Hoeby/Sapphire/README.md

# Sapphire 3d printer mods

I made some mods to the Sapphire and in particular for the SP3.
Everything is still in testing, use is on your own risk
