Hoeby/Sapphire/triple-z_mod/readme.md

For changing the sapphire SP3 to triple z, i tried to explain every step <br>
Some parts in the pictures could look different, because i am still fine tuning parts. <br>
It is not a commercial modification, use it on you own risk. If there are any deviations, these cannot be recovered. <br>

This mod isn't going about how to wire everything, just the mechanical part. <br>
<p align="center">
  
</p>

# Index:
- <a href="assets/step1_checksquare/readme.md">Align extrusion profiles that they are square</a>
- <a href="assets/step2_left-right_alignparts/readme.md">Front left and right new parts, check before drilling</a>
- <a href="assets/step3_left-right_drilling/readme.md">Front left and right, drilling the holes in the base</a>
- <a href="assets/step4_rear_drilling/readme.md">Rear profile position, drilling the holes in the base</a>
- <a href="assets/step5_mount_rear/readme.md">Mounting rear profile</a>
- <a href="assets/step6_steppermount/readme.md">Mounting stepper motors</a>
- <a href="assets/step7_mount_carriages/readme.md">Mount rail carriages</a>
- <a href="assets/step8_gantry/readme.md">Making gantry</a>
- <a href="assets/step9_mount_bed/readme.md">Mounting bed</a>
<br>
To give you a start, i added the necessary config i am using for z-tilt. <br>
This config is not a complete config for klipper. Only the values needed for z-tilt. <br>
I am using a btt octopus mainboard, check you mainboard pins in your config. <br>
<a href="assets/klipper_config/z_stepper.md">Very basic config for Z-tilt in klipper</a>

## BOM list:
3x  MGN9H linear rail, 300mm long <br>
3x  nema 17 stepper, tr8 x 300mm (spindle and stepper are 1 part) <br>
3x  POM Anti Backlash Nuts For Leadscrew (must fit your spindles) <br>
3x  thrust bearing F8-16M (8x16x5mm) <br>
3x  axis mounting ring (8x25x8mm) <br>
9x  BHCS m3x6mm screw <br>
24x SHDC m3x8mm screw <br>
20x  SHDC m3x12mm screw <br>
4x  SHDC m3x14mm screw <br>
12x SHDC m3x16mm screw <br>
6x SHDC m3x20mm screw <br>
4x SHDC m3x??mm screw (depending on used bed)<br>
26x  BHCS m5x10mm screw <br>
3x SHDC m5x20mm screw <br>
3x  SHDC m6x20mm screw <br>
1x  m6 washer <br>
28x T-nut, spring loaded type for 20 series - M3 <br>
18x T-nut, spring loaded type for 20 series - M5 <br>
3x nut - M5 <br>
4x thumb nut M5 <br>
8x hammernut for 20 series - M5 <br>
6x Threaded inserts M3x5 <br>
3x IGUS eglm05 (cheaper option: GE5C bearing) <br>

### Profiles BOM list:
1x 2020 profile 303,0mm long <br>
1x 2020 profile 334,5mm long <br>
1x 2020 profile 316,0mm long <br>
2x 2020 profile 225,0mm long <br>
1x 2020 profile 189,0mm long <br>
