Hoeby/Sapphire/IO-mount_klicky/beta/readme.md

Made a new A_bottom_sensor to mount on IO-mount for sapphire 

It is designed to use the default NG klicky probe. 
To find the default parts/instructions go to: https://github.com/jlas1/Klicky-Probe

Using it for my own purpose on a SP3
https://cults3d.com/en/3d-model/tool/io-mount-a-premium-toolhead-design-for-twotrees-corexy-systems-sp-3-version
