Hoeby/Sapphire/IO-mount_klicky/beta/klicky_dock_v2.stp

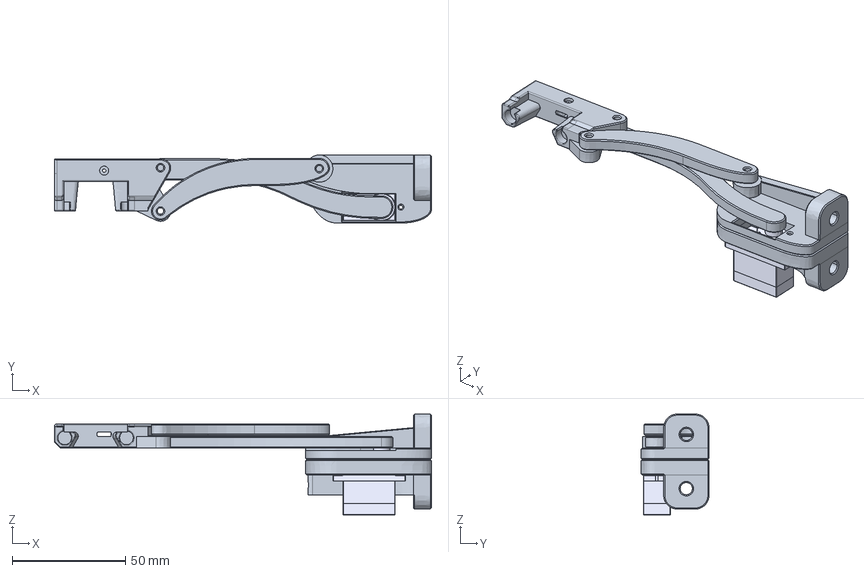
[picture p4: CAD file, 2024-04-14]
IO-mount_klicky/beta/klicky_dock_v2.stp
166.3 x 30.0 x 44.5 mm
servo motor part 1
servo motor part 2
servo motor part 3
