Hoeby/Sapphire/triple-z_mod/.stl_files/2020_profile_spacers/extrusion space 0.2.stl

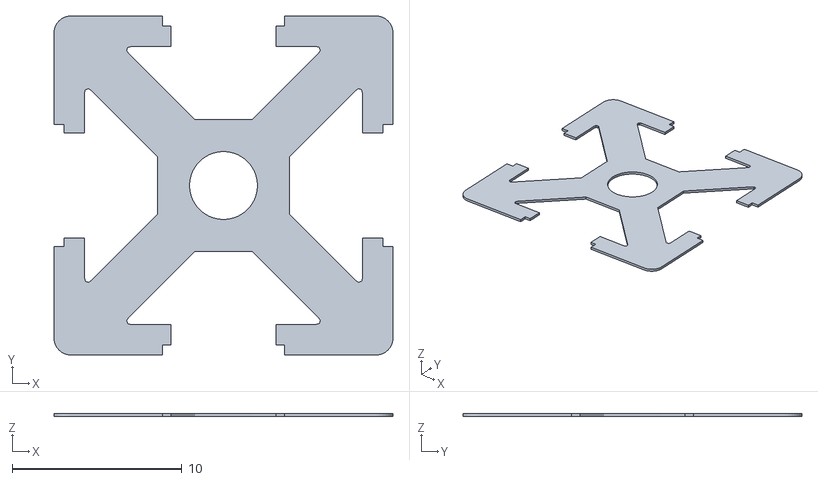
[picture p5: CAD file, 2024-03-03]
triple-z_mod/.stl_files/2020_profile_spacers/extrusion space 0.2.stl
20.0 x 20.0 x 0.197
