Hoeby/Sapphire/triple-z_mod/.stl_files/corner_bracket/extrusionbracket.stl

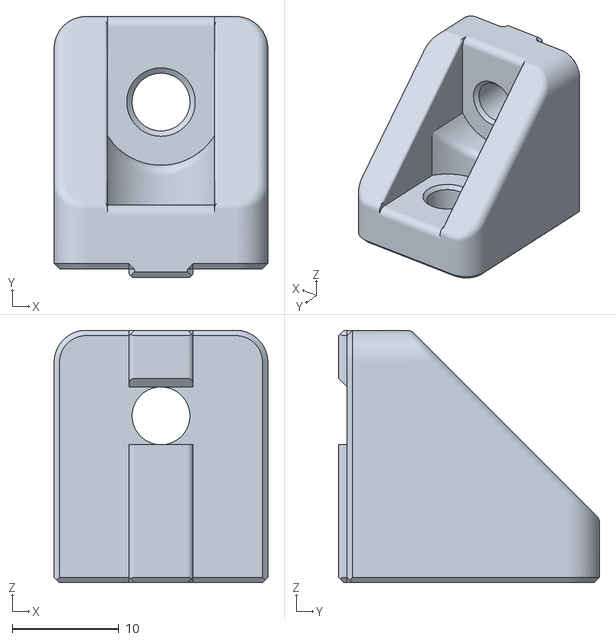
[picture p6: CAD file, 2024-02-25]
triple-z_mod/.stl_files/corner_bracket/extrusionbracket.stl
20.0 x 24.4 x 23.6
