Hoeby/Sapphire/triple-z_mod/.stl_files/drill_jigs/back_extrusion_position/z_drill_jig_back_profile.stl

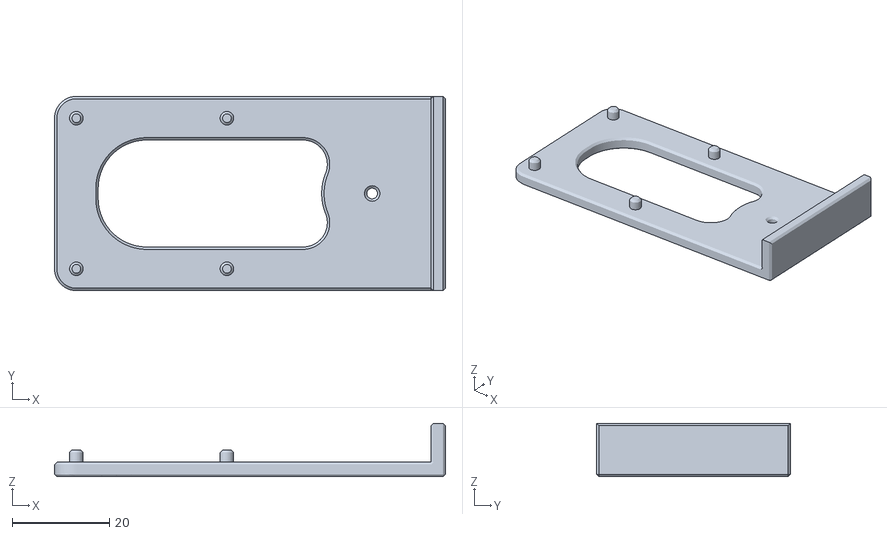
[picture p7: CAD file, 2024-02-15]
triple-z_mod/.stl_files/drill_jigs/back_extrusion_position/z_drill_jig_back_profile.stl
80.5 x 40.0 x 11.0
