Hoeby/Sapphire/triple-z_mod/.stl_files/drill_jigs/stepper_spindle/z_drill_jig_stepper.stl

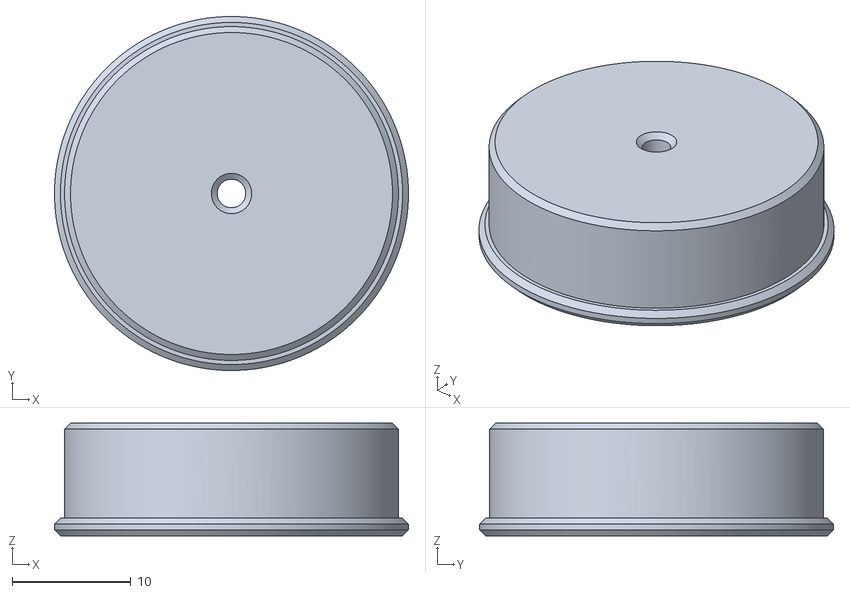
[picture p8: CAD file, 2024-02-15]
triple-z_mod/.stl_files/drill_jigs/stepper_spindle/z_drill_jig_stepper.stl
29.8 x 29.8 x 9.50
