Hoeby/Sapphire/triple-z_mod/.stl_files/stepper_distance_plate_3x/stepper_distance_plate.stl

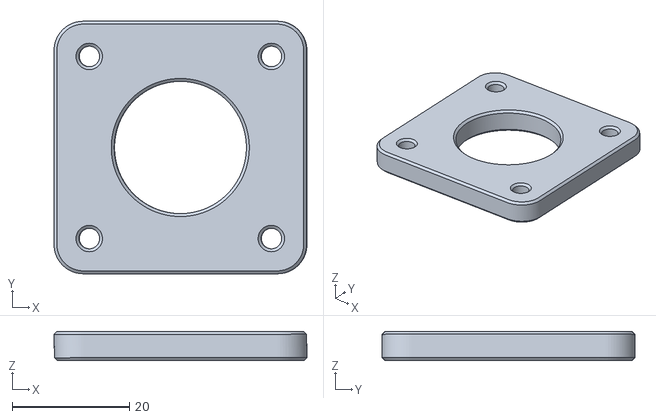
[picture p9: CAD file, 2024-02-15]
triple-z_mod/.stl_files/stepper_distance_plate_3x/stepper_distance_plate.stl
43.1 x 43.0 x 4.99
