Hoeby/Sapphire/triple-z_mod/.stl_files/z_bed_left_1x/z_bed_left.stl

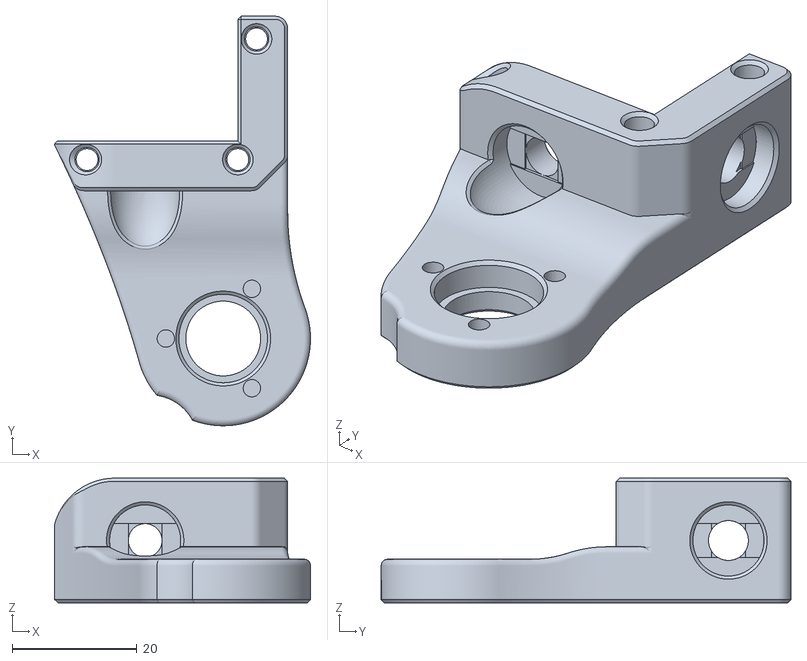
[picture p10: CAD file, 2024-02-25]
triple-z_mod/.stl_files/z_bed_left_1x/z_bed_left.stl
41.1 x 65.7 x 20.0
