Hoeby/Sapphire/triple-z_mod/.stl_files/z_bed_left_plate_1x/z_bed_left_plate.stl

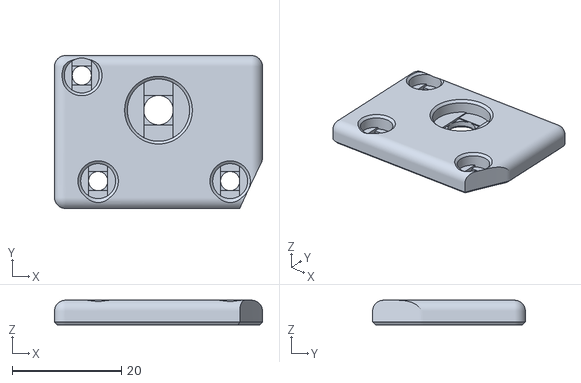
[picture p11: CAD file, 2024-02-25]
triple-z_mod/.stl_files/z_bed_left_plate_1x/z_bed_left_plate.stl
38.1 x 28.0 x 4.50
