Hoeby/Sapphire/triple-z_mod/.stl_files/z_bed_rear_1x/z_bed_rear.stl

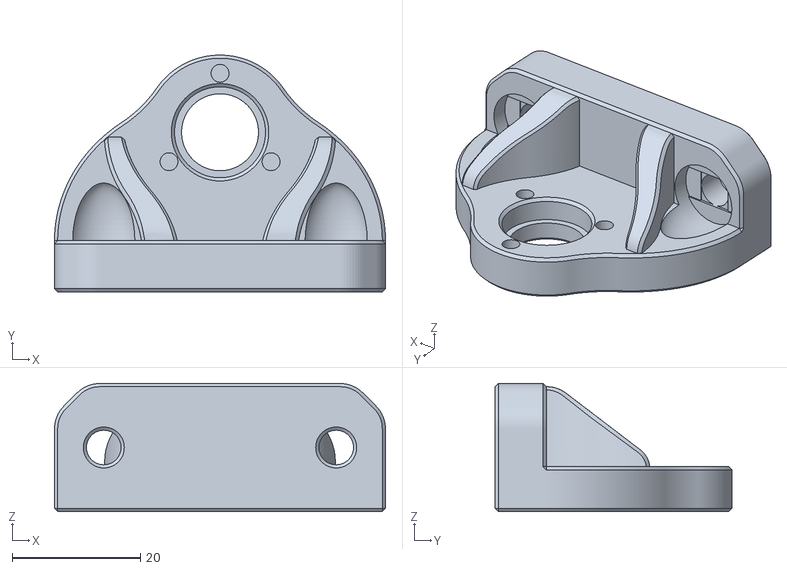
[picture p12: CAD file, 2024-02-25]
triple-z_mod/.stl_files/z_bed_rear_1x/z_bed_rear.stl
51.7 x 37.0 x 20.0
