Hoeby/Sapphire/triple-z_mod/.stl_files/z_carriage_left_1x/z_carriage_left.stl

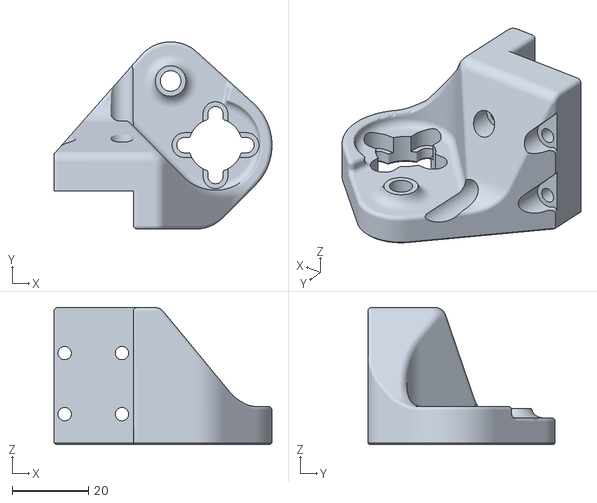
[picture p13: CAD file, 2024-02-15]
triple-z_mod/.stl_files/z_carriage_left_1x/z_carriage_left.stl
57.1 x 49.1 x 35.9
