Hoeby/Sapphire/triple-z_mod/.stl_files/z_carriage_rear_1x/z_carriage_rear.stl

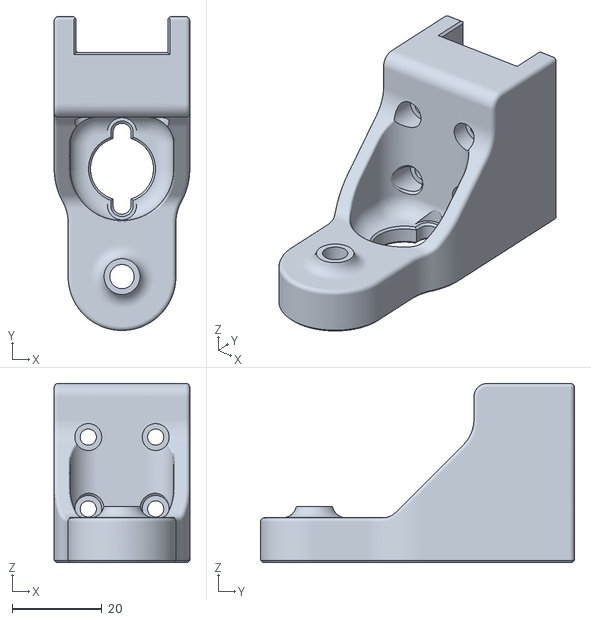
[picture p14: CAD file, 2024-02-15]
triple-z_mod/.stl_files/z_carriage_rear_1x/z_carriage_rear.stl
30.2 x 69.9 x 39.9
