Hoeby/Sapphire/triple-z_mod/.stl_files/z_stepper_left_1x/z_stepper_left.stl

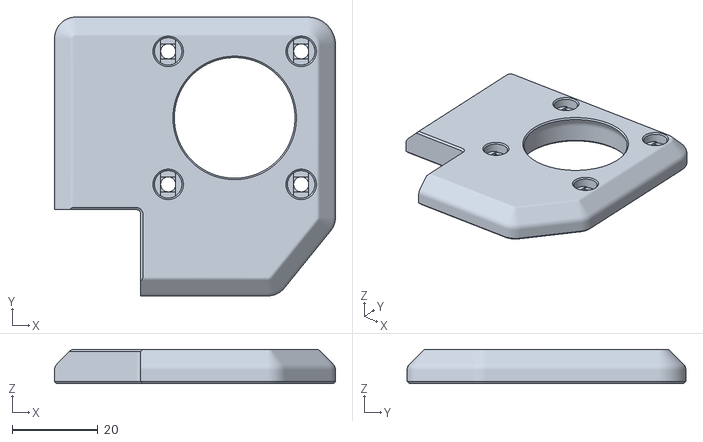
[picture p15: CAD file, 2024-02-15]
triple-z_mod/.stl_files/z_stepper_left_1x/z_stepper_left.stl
65.5 x 65.0 x 8.00
