Hoeby/Sapphire/triple-z_mod/.stl_files/z_stepper_rear_1x/z_stepper_rear.stl

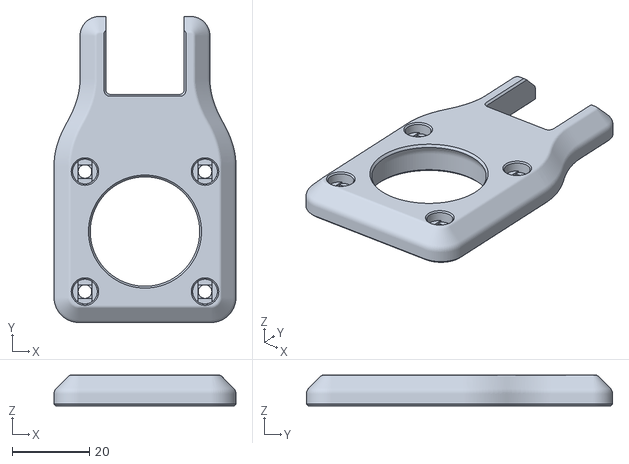
[picture p16: CAD file, 2024-02-15]
triple-z_mod/.stl_files/z_stepper_rear_1x/z_stepper_rear.stl
47.0 x 79.1 x 8.00
