Hoeby/Sapphire/IO-mount_klicky/beta/A_Bottom_Sensors_klicky.stl

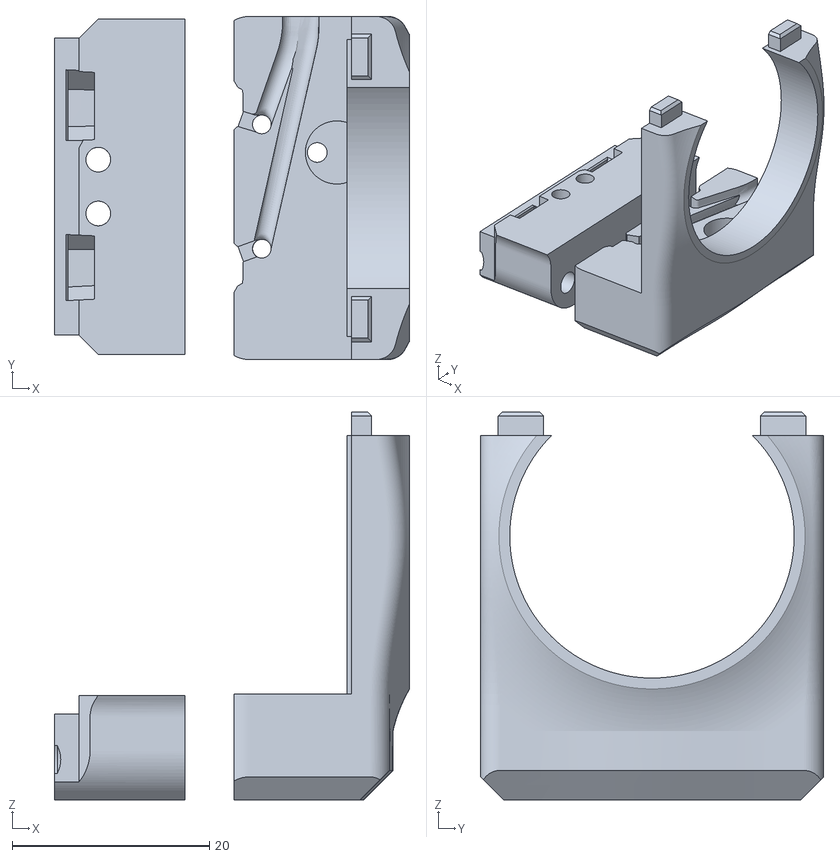
[picture p17: CAD file, 2024-01-31]
IO-mount_klicky/beta/A_Bottom_Sensors_klicky.stl
36.0 x 34.8 x 39.4
