Hoeby/Sapphire/triple-z_mod/.stl_files/z_carriage_left_1x/z_carriage_left_orginal_voron_trident.stl

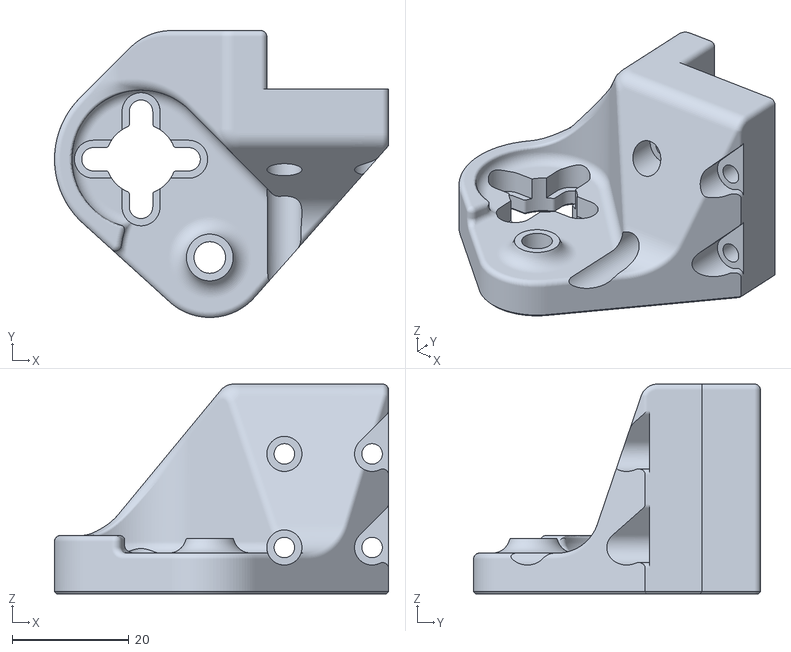
[picture p19: CAD file, 2024-02-15]
triple-z_mod/.stl_files/z_carriage_left_1x/z_carriage_left_orginal_voron_trident.stl
57.1 x 49.1 x 35.9
