Hoeby/Sapphire/triple-z_mod/.stl_files/2020_profile_spacers/extrusion space 0.6.stl

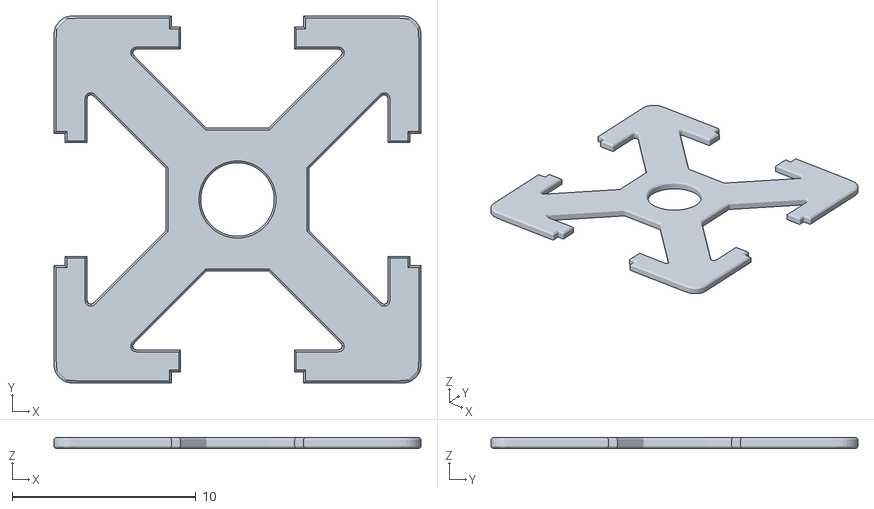
[picture p20: CAD file, 2024-03-03]
triple-z_mod/.stl_files/2020_profile_spacers/extrusion space 0.6.stl
20.0 x 20.0 x 0.597
