Hoeby/Sapphire/(list of files, cad)

Other CAD files:
triple-z_mod/.stl_files/z_carriage_right_1x/z_carriage_right.stl
triple-z_mod/.stl_files/z_stepper_right_1x/z_stepper_right.stl
triple-z_mod/.stl_files/z_carriage_right_1x/z_carriage_right_orginal_voron_trident.stl
IO-mount_klicky/beta/klicky.stl
