Hoeby/Sapphire/triple-z_mod/assets/step7_mount_carriages/readme.md

# Sapphire SP3 triple-z mod

## Mount rail carriages
Needed for these steps: <br>
- 8x SHDC m3x12mm screw <br>
- 4x SHDC m3x14mm screw <br>

Mount to the 3 rail carriages, the 3D printed parts. <br>
The parts in the front are mounted with SHDC M3x12 screws. <br>
The parts in the rear is mounted with SHDC M3x14 screws. <br>

<p align="center">
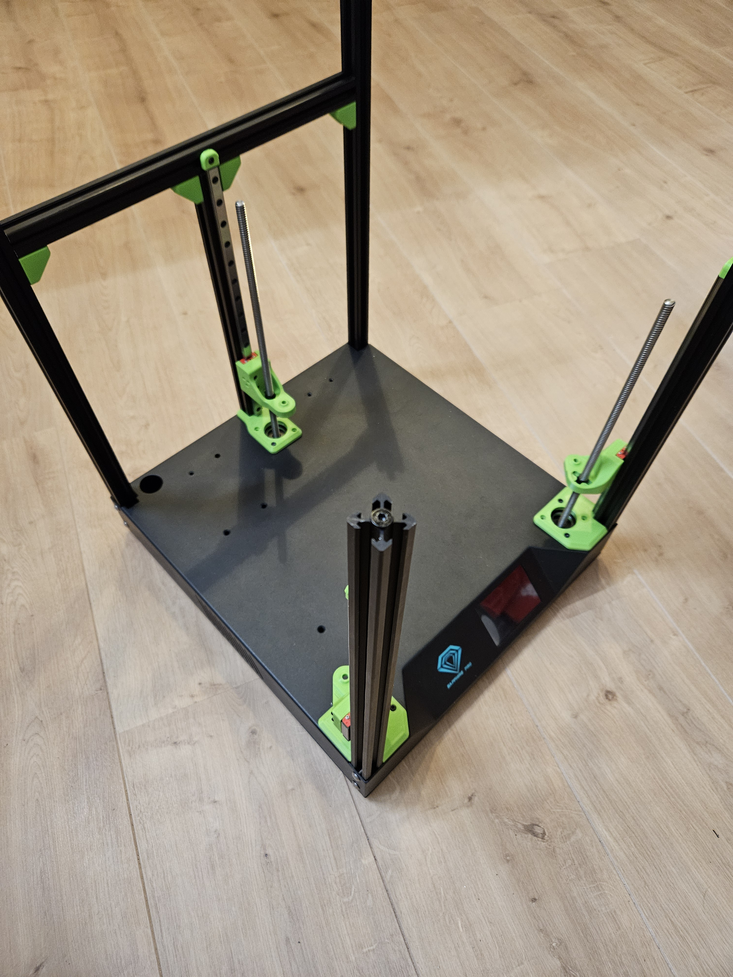
[picture p25: triple-z_mod/assets/pictures/20240104_102458.jpg]
  
</p>

Go to the next step: <a href="../step8_gantry/readme.md">Making Gantry</a>
