Hoeby/Sapphire/triple-z_mod/assets/step3_left-right_drilling/readme.md

# Sapphire SP3 triple-z mod

## Front left and right, drilling the holes in the base
Only do these steps, if you are sure the aligment is perfect. <br>

Start drilling the holes. Use the z-stepper plates as a jig. <br>
Drill only the 2 holes that are closed to the screen side. <br>
The holes need to be 3mm in diameter. <br>
<p align="center">
  
</p>

When the first 2 holes are done, place some screws in the holes, that the z-stepper plate will not move. <br>
Remove the z-carriage and use the jig to drill the hole for the spindle. <br>
<p align="center">
  
</p>

The hole for the spindle has to be enlarged, that a thrust bearing can go tru the hole. <br>
On mine i made them 20mm diameter. <br>
This is how it looks, when all holes for the front steppes are done (1 side shown)
<p align="center">
  
</p>

Go to the next step: <a href="../step4_rear_drilling/readme.md">Rear profile position, drilling the holes in the base</a>
