Hoeby/Sapphire/triple-z_mod/assets/pictures/20240213_113906.jpg

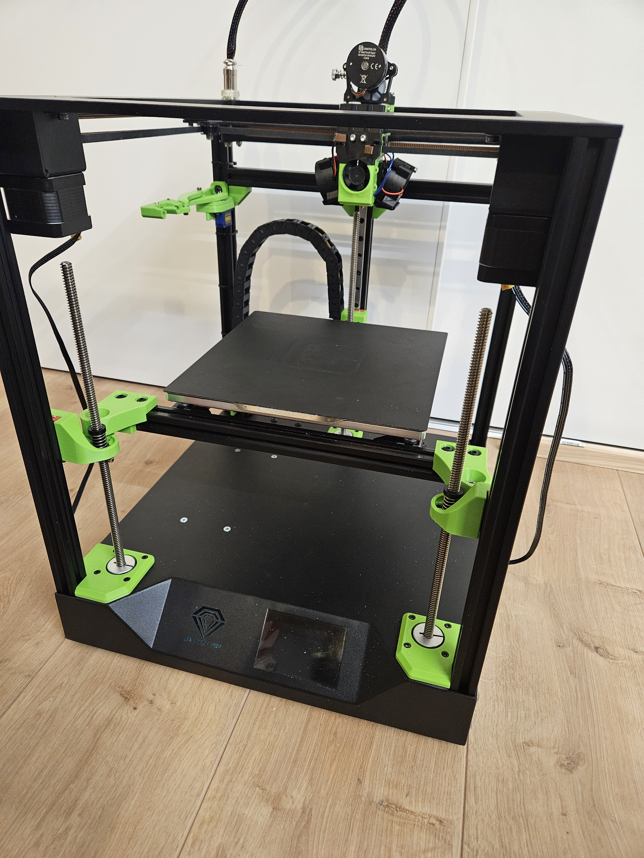
[picture p1: triple-z_mod/assets/pictures/20240213_113906.jpg]
triple-z_mod/assets/pictures/20240213_113906.jpg
