Hoeby/Sapphire/triple-z_mod/assets/pictures/20240102_181815.jpg

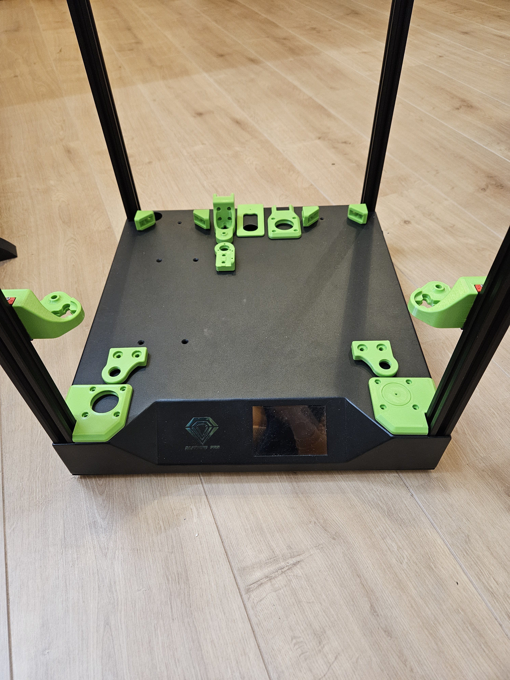
triple-z_mod/assets/pictures/20240102_181815.jpg
