Hoeby/Sapphire/triple-z_mod/assets/pictures/20240102_181830.jpg

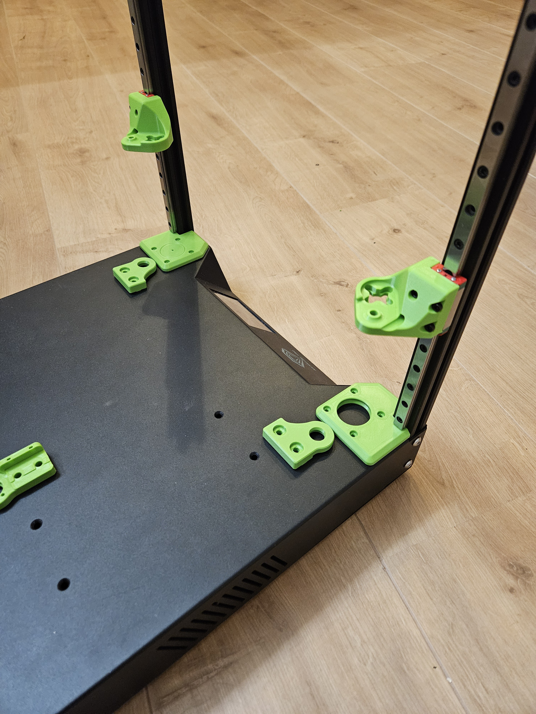
triple-z_mod/assets/pictures/20240102_181830.jpg
