Hoeby/Sapphire/triple-z_mod/assets/pictures/20240226_180545.jpg

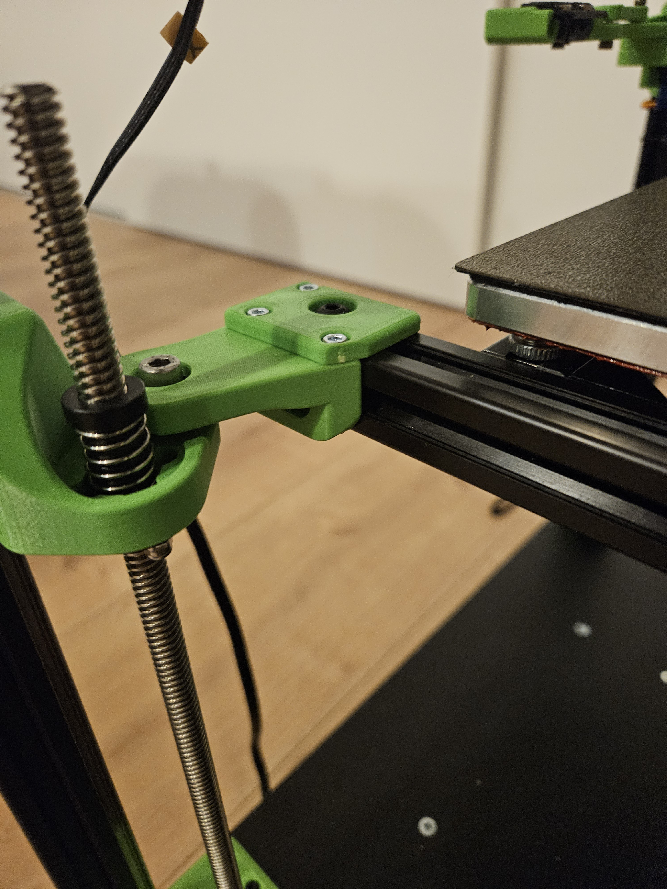
[picture p23: triple-z_mod/assets/pictures/20240226_180545.jpg]
triple-z_mod/assets/pictures/20240226_180545.jpg
