Hoeby/Sapphire/triple-z mod/assets/pictures/20240103_202405.jpg

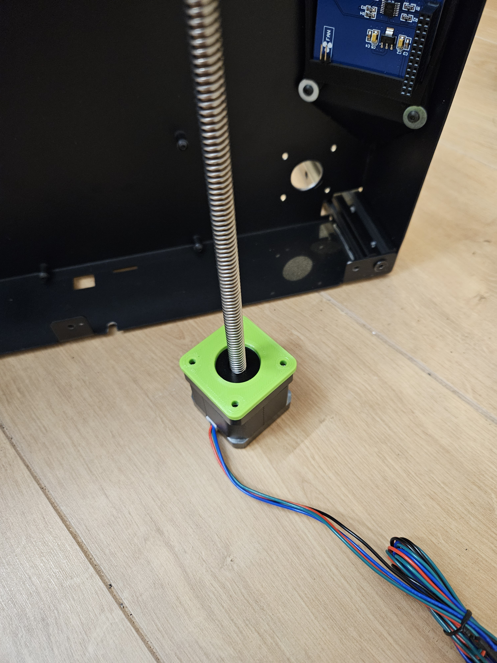
[picture p26: triple-z_mod/assets/pictures/20240103_202405.jpg]
triple-z mod/assets/pictures/20240103_202405.jpg
