Hoeby/Sapphire/triple-z_mod/assets/pictures/20240118_200012.jpg

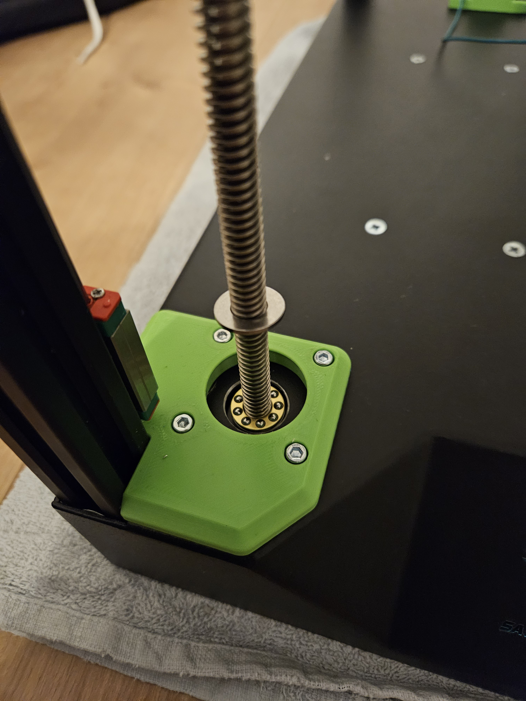
[picture p28: triple-z_mod/assets/pictures/20240118_200012.jpg]
triple-z_mod/assets/pictures/20240118_200012.jpg
