Hoeby/Sapphire/triple-z mod/assets/pictures/20240118_200029.jpg

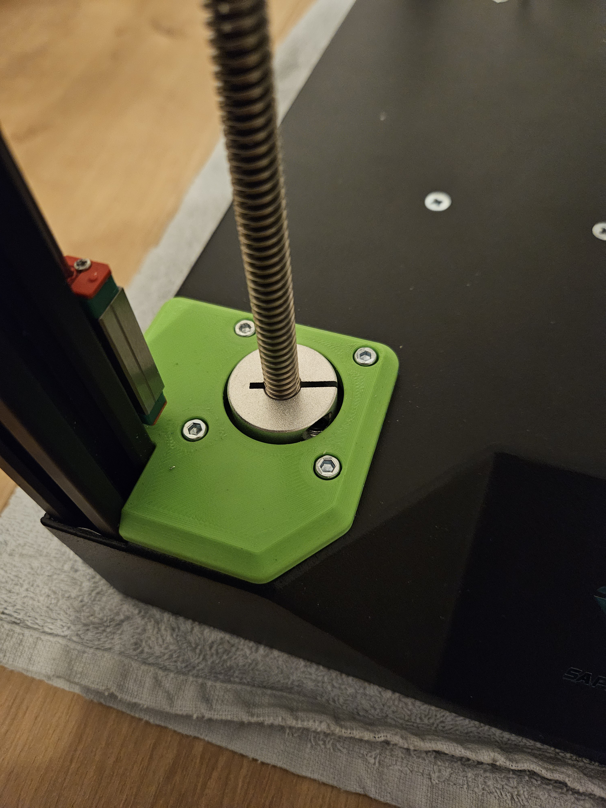
[picture p29: triple-z_mod/assets/pictures/20240118_200029.jpg]
triple-z mod/assets/pictures/20240118_200029.jpg
