Hoeby/Sapphire/triple-z_mod/assets/pictures/20240104_095440.jpg

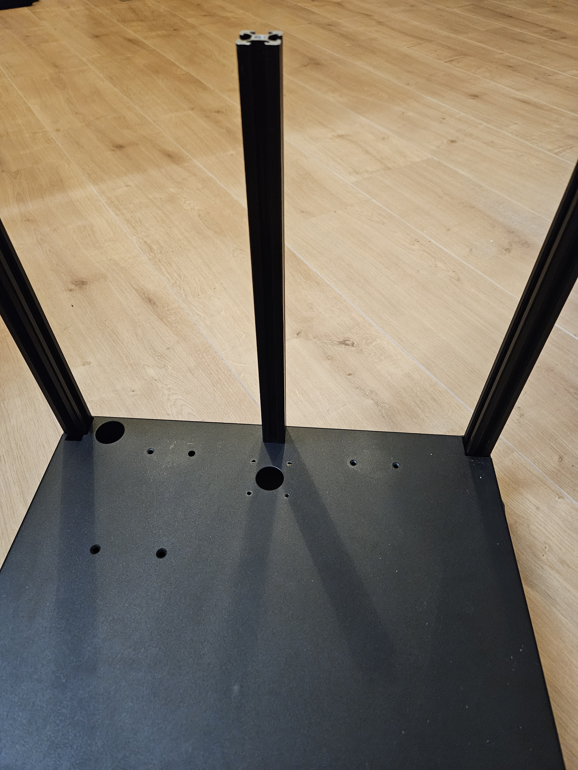
[picture p30: triple-z_mod/assets/pictures/20240104_095440.jpg]
triple-z_mod/assets/pictures/20240104_095440.jpg
