Hoeby/Sapphire/triple-z_mod/assets/pictures/20240104_102151.jpg

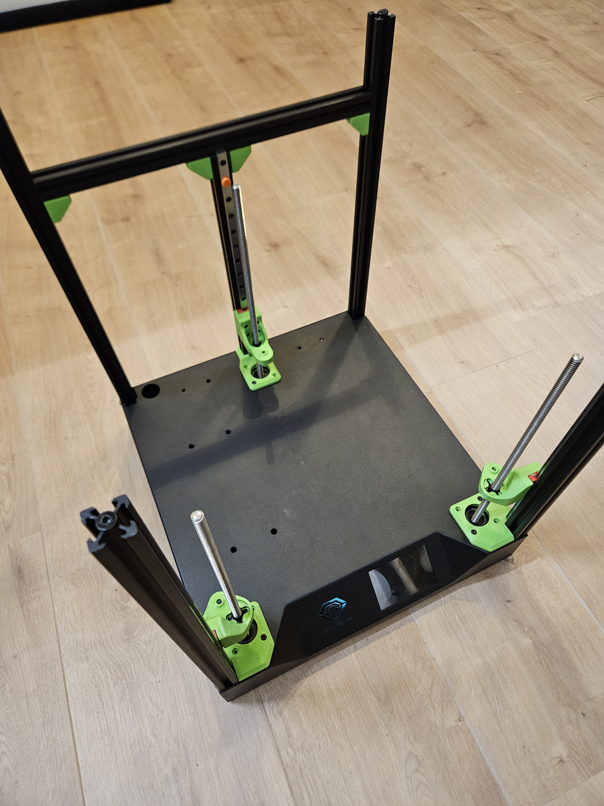
[picture p31: triple-z_mod/assets/pictures/20240104_102151.jpg]
triple-z_mod/assets/pictures/20240104_102151.jpg
