Hoeby/Sapphire/triple-z mod/assets/pictures/20240104_094700.jpg

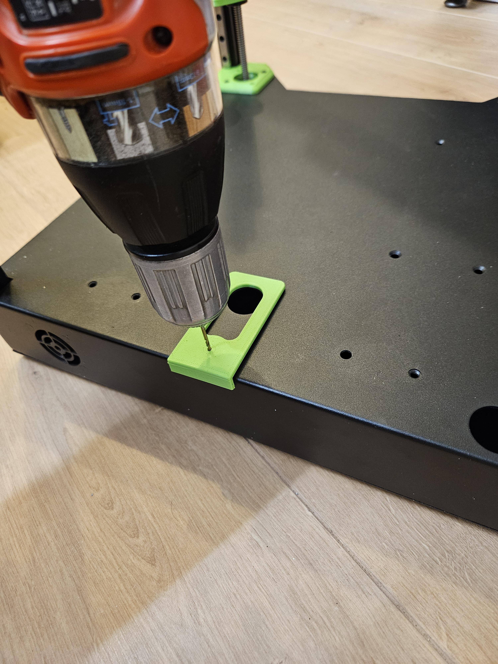
[picture p32: triple-z_mod/assets/pictures/20240104_094700.jpg]
triple-z mod/assets/pictures/20240104_094700.jpg
