Hoeby/Sapphire/triple-z mod/assets/pictures/20240102_144706.jpg

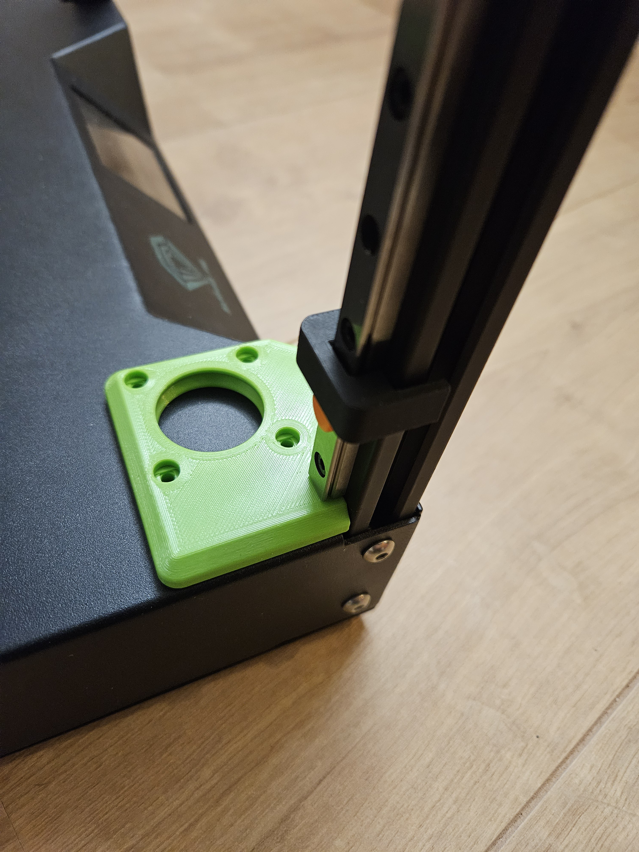
[picture p33: triple-z_mod/assets/pictures/20240102_144706.jpg]
triple-z mod/assets/pictures/20240102_144706.jpg
