Hoeby/Sapphire/triple-z mod/assets/pictures/20231231_110421.jpg

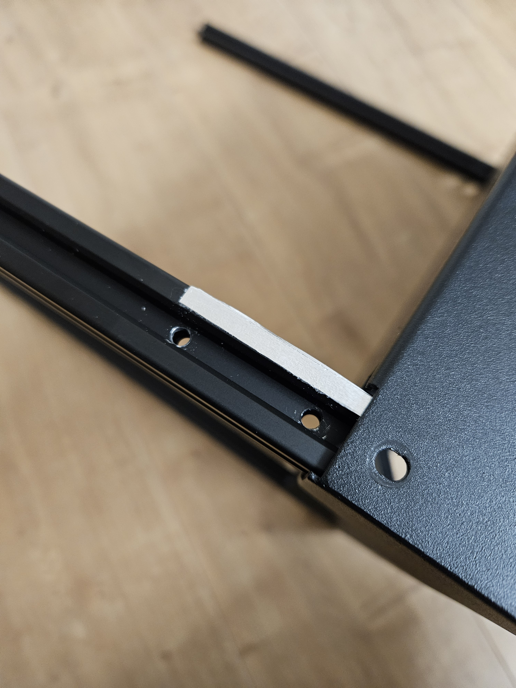
[picture p34: triple-z_mod/assets/pictures/20231231_110421.jpg]
triple-z mod/assets/pictures/20231231_110421.jpg
