Hoeby/Sapphire/triple-z mod/assets/pictures/20240103_192722.jpg

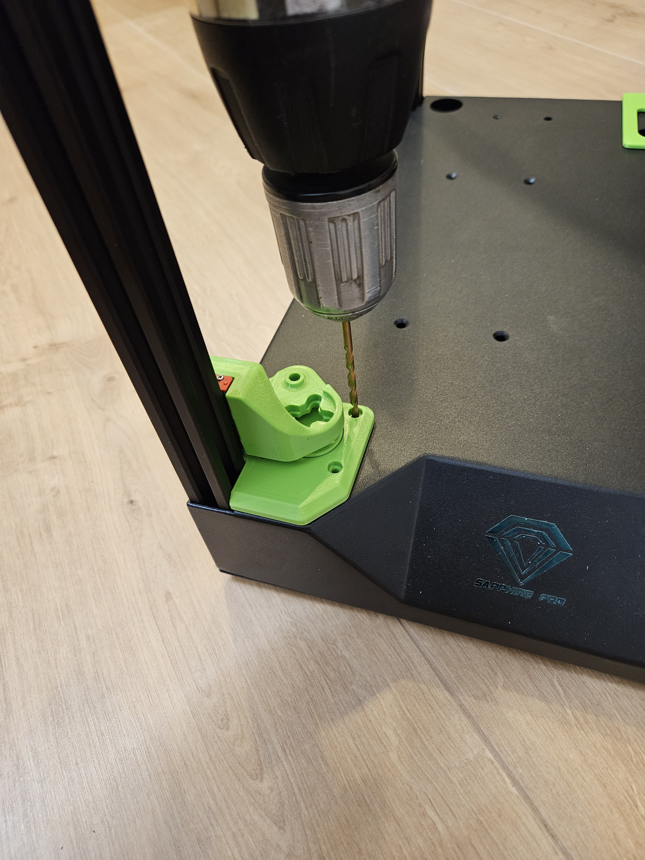
[picture p36: triple-z_mod/assets/pictures/20240103_192722.jpg]
triple-z mod/assets/pictures/20240103_192722.jpg
