Hoeby/Sapphire/triple-z mod/assets/pictures/20240103_193627.jpg

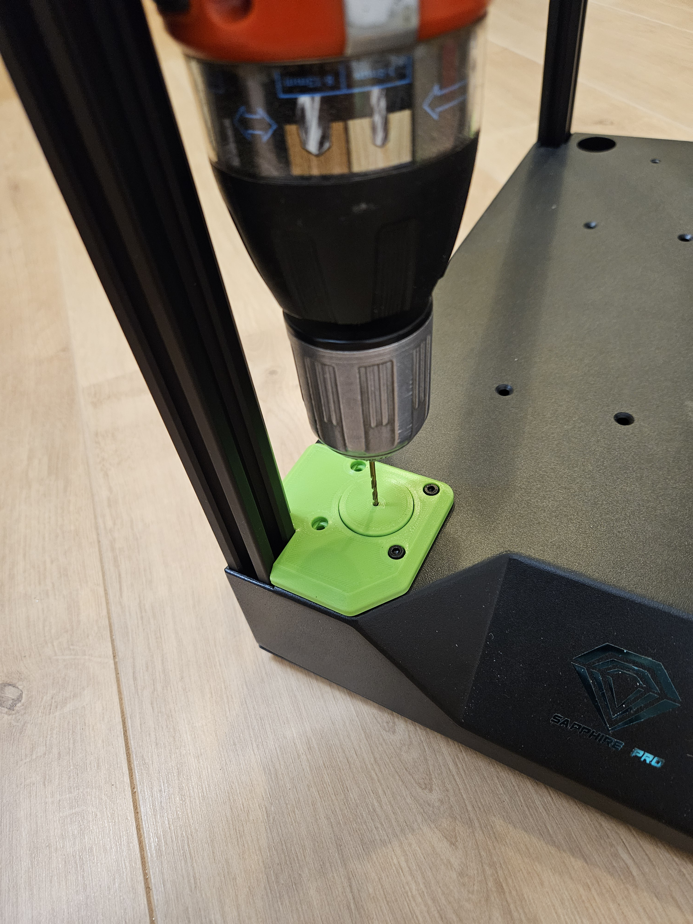
[picture p37: triple-z_mod/assets/pictures/20240103_193627.jpg]
triple-z mod/assets/pictures/20240103_193627.jpg
