Hoeby/Sapphire/triple-z mod/assets/pictures/20240103_201842.jpg

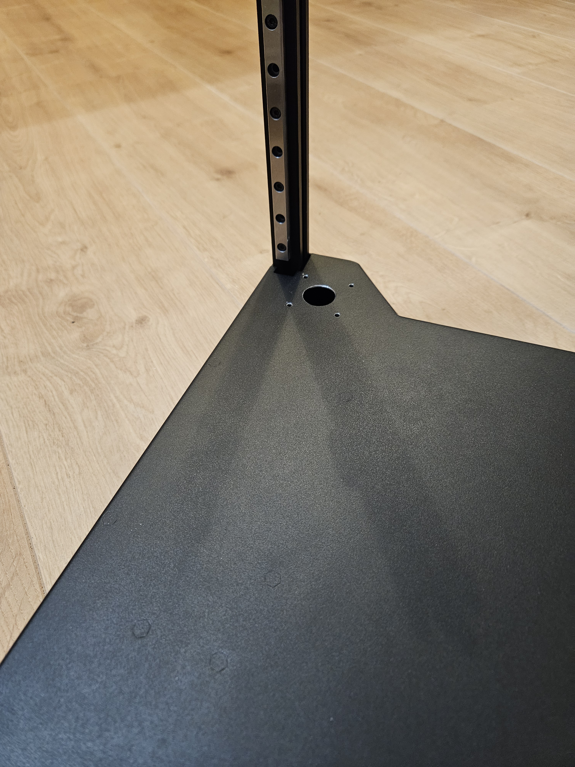
[picture p38: triple-z_mod/assets/pictures/20240103_201842.jpg]
triple-z mod/assets/pictures/20240103_201842.jpg
